Ananoduerme/Ecoguard/BOM_Emitter.xlsx

Bill of Materials (BOM) — Emitter Node
Designator | Component (model/part no.) | Number | Cost per unit (USD) | Total cost (USD) | Source of materials | Material type | Notes
A1 | Battery holder (2x18650) | 1 | $0.17 | $0.17 | https://es.aliexpress.com/item/1005003099547301.html?curPageLogUid=MbcUSyHYDEGK | polymer | Labeled components photo (A1).
A2 | Rocker switch (ON/OFF) | 1 | $0.42 | $0.42 | https://es.aliexpress.com/item/1005008778176373.html?curPageLogUid=7gIBa3QJUuWY | polymer | Labeled components photo (A2).
A3 | ESP32 development board (ESP-WROOM-32) | 1 | $10.09 | $10.09 | https://es.aliexpress.com/item/1005008341916999.html?curPageLogUid=FMwizPmD43Vt | semiconductor | Labeled components photo (A3).
A4 | Li-ion cells 18650 (3.7 V) | 2 | $7.91 | $15.82 | https://es.aliexpress.com/item/1005010036622067.html?curPageLogUid=ruBuxMa2PnuG | other | Labeled components photo (A4).
A5 | Arduino Nano 33 BLE Sense (integrated microphone) | 1 | $47.72 | $47.72 | https://es.aliexpress.com/item/1005009206152855.html?curPageLogUid=K9oVQeTE3ss9 | semiconductor | Labeled components photo (A5).
A6 | Linear regulator 5 V (TO-220, e.g., 7805) | 1 | $0.45 | $0.45 | https://es.aliexpress.com/item/1005003711055538.html?curPageLogUid=Sdd7uUxHTzd9 | semiconductor | Labeled components photo (A6).
A7 | LoRa module Ebyte E220-900T30D (or equivalent) | 1 | $10.14 | $10.14 | https://es.aliexpress.com/item/1005010586468893.html?curPageLogUid=Vvtci6Jekddb | semiconductor | Labeled components photo (A7).
A8 | Linear regulator 3.3 V (TO-220, e.g., LM1117-3.3) | 1 | $0.21 | $0.21 | https://es.aliexpress.com/item/33003651682.html?curPageLogUid=vSk1OgNOU0ZY | semiconductor | Labeled components photo (A8).
Estimated total |  |  |  | $85.02
