Ananoduerme/Ecoguard/BOM_Gateway.xlsx

Bill of Materials (BOM) — Gateway Node
Designator | Component (model/part no.) | Number | Cost per unit (USD) | Total cost (USD) | Source of materials | Material type | Notes
A9 | Battery holder (2x18650) | 1 | $0.17 | $0.17 | https://es.aliexpress.com/item/1005003099547301.html?curPageLogUid=MbcUSyHYDEGK | polymer | Labeled components photo (A9).
A9 | Li-ion cells 18650 (3.7 V) | 2 | $7.91 | $15.82 | https://es.aliexpress.com/item/1005010036622067.html?curPageLogUid=ruBuxMa2PnuG | other | Typically used with battery holder (A9).
A10 | Rocker switch (ON/OFF) | 1 | $0.42 | $0.42 | https://es.aliexpress.com/item/1005008778176373.html?curPageLogUid=7gIBa3QJUuWY | polymer | Labeled components photo (A10).
A11 | ESP32 development board (ESP-WROOM-32) | 1 | $10.09 | $10.09 | https://es.aliexpress.com/item/1005008341916999.html?curPageLogUid=FMwizPmD43Vt | semiconductor | Labeled components photo (A11).
A12 | GSM module board (SIM800L or equivalent) | 1 | $4.00 | $4.00 | https://es.aliexpress.com/item/1005006221441189.html?curPageLogUid=QZUpDdANzlEw | semiconductor | Labeled components photo (A12).
A13 | LoRa module Ebyte E220-900T30D (or equivalent) | 1 | $10.14 | $10.14 | https://es.aliexpress.com/item/1005010586468893.html?curPageLogUid=Vvtci6Jekddb | semiconductor | Labeled components photo (A13).
A14 | DC-DC buck converter module (LM2596) | 1 | $0.61 | $0.61 | https://es.aliexpress.com/item/1005010140577289.html?curPageLogUid=41BA096eIaod | semiconductor | Labeled components photo (A14).
A15 | Linear regulator 5 V (TO-220, e.g., 7805) | 1 | $0.45 | $0.45 | https://es.aliexpress.com/item/1005003711055538.html?curPageLogUid=Sdd7uUxHTzd9 | semiconductor | Labeled components photo (A15).
A16 | Linear regulator 3.3 V (TO-220, e.g., LM1117-3.3) | 1 | $0.21 | $0.21 | https://es.aliexpress.com/item/33003651682.html?curPageLogUid=vSk1OgNOU0ZY | semiconductor | Labeled components photo (A16).
Estimated total |  |  |  | $41.91
