Ananoduerme/Ecoguard/Base_Gateway.SLDPRT

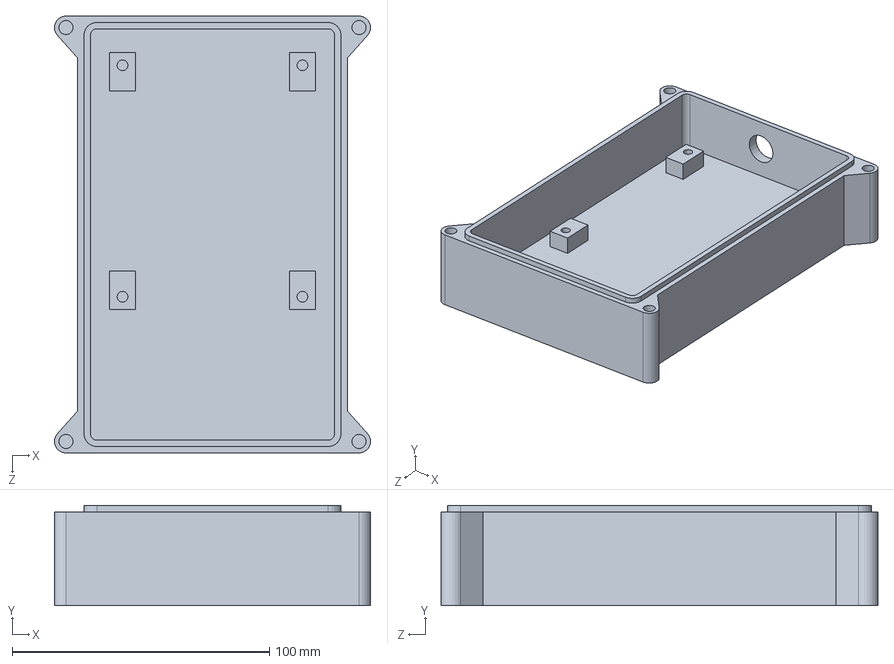
[picture p1: CAD file, 2026-01-01]
Base_Gateway.SLDPRT
123.0 x 39.0 x 170.0 mm
