Ananoduerme/Ecoguard/Tapa_Emisor.SLDPRT

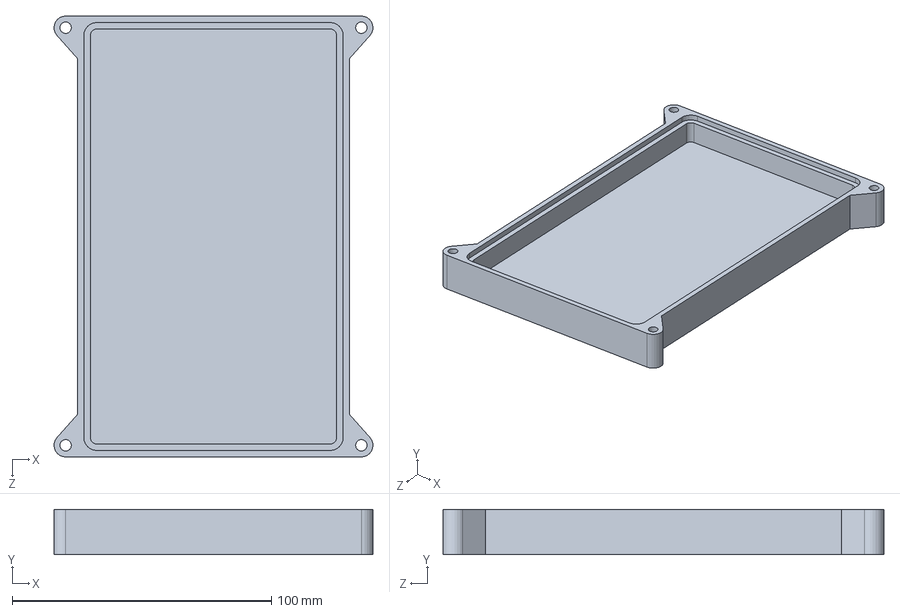
[picture p2: CAD file, 2026-01-01]
Tapa_Emisor.SLDPRT
123.0 x 17.5 x 170.0 mm
