Ananoduerme/Ecoguard/(list of files, cad)

Other CAD files:
Base_Emisor.STL
Base_Gateway.STL
Tapa_Emisor.STL
Tapa_Gateway.STL
