Ananoduerme/Ecoguard/Schematic_Emisor.pdf

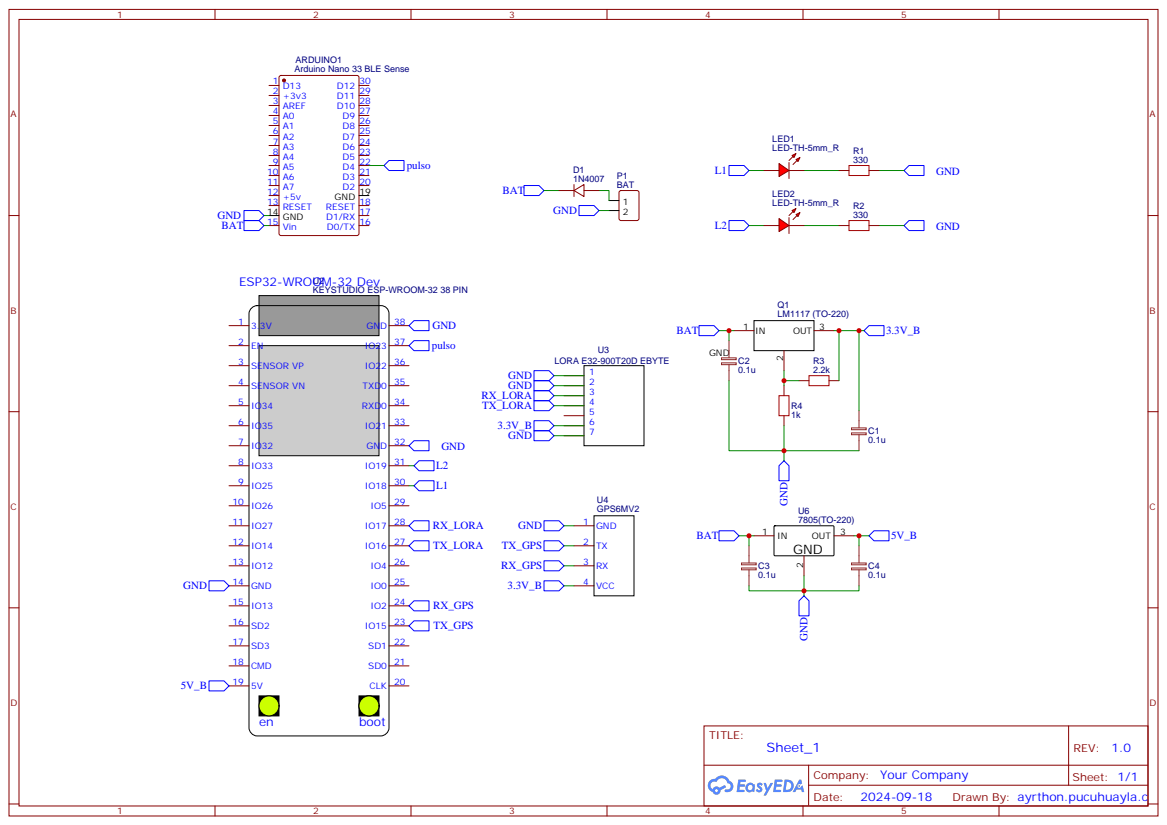
[picture p3: page 1]

KEYSTUDIO ESP-WROOM-32 38 PIN

Drawn By: ayrthon.pucuhuayla.c
