Ananoduerme/Ecoguard/Schematic_gateway.pdf

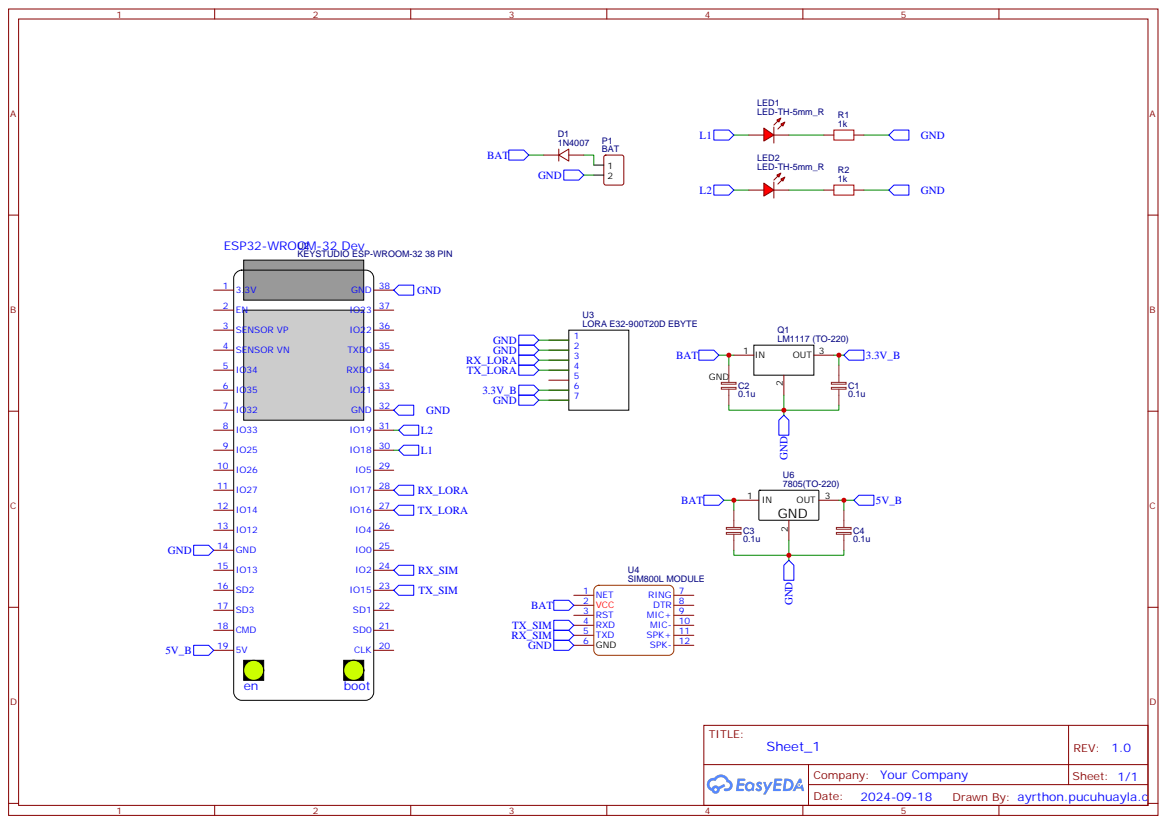
[picture p4: page 1]

KEYSTUDIO ESP-WROOM-32 38 PIN

Drawn By: ayrthon.pucuhuayla.c
