Ananoduerme/Ecoguard/(list of files, drawings)

Other design files:
PCB_gateway.json
PCB_PCB_emisor.json
SCH_Emisor.json
SCH_gateway.json
